MuTerry/microgrid-stm32/README.md

# STM32 微电网控制项目

基于 NUCLEO-F446RE，实现 CAN 功率指令接收、四路 PWM 控制、模拟量采样和电流 PI 控制，逐步接入真实传感器与 Buck 功率级。

**进度更新：2026-11-09**（归档 11 月 8 日第二轮测试；硬件测量已暂停）

**固件基线：`153e2b0`**（CAN、PWM、双 ADC 与电位器反馈 PI 台架测试）

**当前观察固件：`2cbbc6e`**（PA1 原始 ADC 观察模式；后续更新为测试记录与离线分析，未改固件）

当前阶段：**正、反向小电流基础响应与撤载回零均已观察到。新增零输入与 3V3 分压中点对照表现较好；恢复 ACS758 后，ADC 估算与万用表仍差约 9.67 mV。表笔接入与报告间交替波动有关联，原因未定位。测量已暂停，测点与地线压差检查待下次进行。正式标定、精度验证和真实功率 PI 收敛尚未完成。**

当前源码默认 `ADC_RAW_TEST_MODE=1`：只采 PA1、四路 PWM 保持为零、暂停 `0x200` 发送，串口每约 250 ms 输出原始 ADC 数据。下面列出的 CAN 测量反馈和电位器 PI 为既有基线验证结果，不代表观察模式正在执行这些功能。心跳接收与超时锁存仍运行。

## 已完成

### 固件与通信

- [x] 工程备份，固件基线已推送 GitHub。
- [x] CAN 通信测试，波特率 500 kbit/s。
- [x] 接收 `0x100` 功率指令、`0x102` 光伏/风电指令和 `0x101` 心跳，发送 `0x200` 状态反馈。
- [x] TIM3 四路 20 kHz PWM 输出测试：PA6 光伏、PA7 燃料电池、PB0 电池、PB1 风电。
- [x] ADC1 双路采样测试：PA0 模拟母线电压，PA1 模拟电流。
- [x] 光伏单路 PI 的电位器反馈方向与限幅测试；其余三路当前仍为开环控制。
- [x] 心跳超时保护：超过 1000 ms 未收到有效心跳，关闭全部 PWM、置故障码 5 并锁存，手动复位恢复。

**心跳超时关闭并锁存是当前明确保留的行为。总路线资料中的下垂控制不作为当前固件行为。**

### HW-525 / ACS758 硬件测试

- [x] 焊接 HW-525 四针排针和 IP+/IP− 功率引线。
- [x] 使用 20 Ω / 50 W 电阻搭建串联负载回路，断电实测回路约 19.74 Ω。
- [x] 模块独立供电检查，空载耗电约 22 mA。
- [x] 分离供电下完成零电流、正向电流、反向电流及撤载回零测试。
- [x] 在约 ±0.5 A 范围内，确认正向电流使输出升高、反向电流使输出降低，两路输出接近。

以下为人工台架测试记录，测试时 OUT1/OUT2 均未接入 STM32 ADC：

| 状态 | 被测电流 | 模块 VCC | OUT1 | OUT2 |
|---|---:|---:|---:|---:|
| 无电流 | 0 A | 4.957 V | 2.481 V | 2.482 V |
| 正向小电流 | +0.245 A | 4.956 V | 2.490 V | 2.492 V |
| 正向电流 | +0.491 A | 4.958 V | 2.500 V | 2.501 V |
| 撤载回零 | 0 A | 4.958 V | 2.481 V | 2.482 V |
| 反向电流 | −0.491 A | 4.957 V | 2.462 V | 2.462 V |

测试供电：电脑 USB 给 NUCLEO-F446RE 供电，开发板 5 V/GND 给传感器模块供电；台式电源单独给 IP+/IP− 与电阻组成的负载回路供电。

结合模块资料及断电电阻测量，**推断 OUT1 为直接/滤波输出，OUT2 为运放缓冲输出**。尚未完整追踪 PCB 原理图，CJMCU-758 资料与 HW-525 实物也存在版本差异，不能把输出编号对应关系视为完全确认。两路测试结果支持近似相同的直流增益。

本次测得的零点及粗估灵敏度仅用于基础功能判断，尚不是正式标定参数。早期模块与负载共用台式电源的测试数据不用于标定。上述模块独立测试阶段未修改、编译或烧录固件。

### 分压接入记录（2026-10-17）

- [x] 搭建 OUT2 → R1（10 kΩ）→ A；A 经 R2（10 kΩ）接信号地，经 R3（1 kΩ）接 B；B 经 100 nF 电容接信号地。
- [x] B 未接 PA1 时，最后一轮零电流测得模块 VCC=4.973 V、OUT2=2.495 V、B=1.2453 V，静态分压比约 0.49912。
- [x] B 已接 PA1，用户报告 PA1 对地电压为 1.2377 V。两次读数并非同步测量，不能据此直接判断接入造成的压降。

电阻最初在面包板电路中测得 8.884/8.884/1.0077（按 kΩ 理解）；取出后用户报告 10.0013 kΩ。该读数尚未逐一对应 R1/R2，正式标定前应分别记录两只分压电阻的独立测量值。当前不把在电路中的读数用于计算精确分压比。

早期测量曾记录 VCC 约 4.494 V，与最后一轮 4.973 V 不一致，原因未确认；不改写早期记录，也不混合各轮数据标定。静态分压验证不代表完整故障保护验证。

### 原始 ADC 观察验证（2026-10-17）

- [x] 加入并编译原始 ADC 观察固件，用户板端已提供串口截图。
- [x] 截图 28 组输出均为 `n=32 err=0`，合计报告 896 次有效采样。
- [x] `avg=1551～1553`，按暂定 3.300 V 参考电压估算 `mV=1250～1251`。
- [x] 故障状态 `safe=1 fault=5` 下，ADC 观察输出继续。

单次原始值跨组范围为 1544～1562，约对应 14.51 mV 的峰峰范围；组平均值变化仅 2 个码值。这里验证的是采样和输出的基础功能，尚未确认电压准确度、正式零点、完整量程或 ADC 电流跟踪。

详见 [测试分析与结论](docs/tests/2026-10-17-pa1-adc-raw.md)、[原始截图](docs/tests/assets/2026-10-17-pa1-adc-raw.png) 和 [逐行转录 CSV](docs/tests/data/2026-10-17-pa1-adc-raw.csv)。截图不含时间戳，CSV 是统计输出转录，不是逐点原始波形。

### 静态电压与电流响应复核（2026-10-20）

- [x] 一组同轮静态数据中，OUT2=2.380 V、PA1=1.1909 V，分压比约 0.50038；用开发板实测 3.291 V 近似参考电压，`avg=1480` 对应约 1.1894 V，相差约 1.5 mV。
- [x] 正向 +0.484 A 时，相对本轮前后零点平均值，PA1 上升 9.8 mV、ADC 增加 12 个计数；撤载后回到初始值附近。
- [x] 反向 −0.490 A 时，PA1 和 ADC 均下降，方向符合预期。
- 当日反向幅度未对齐：PA1 实测变化 −5.9 mV，ADC 变化 −12.5 个计数；若参考电压约 3.29 V，后者约对应 −10.0 mV。该历史轮次不作标定，后续进展见 11 月 8 日记录。

串口曾无法打开、随后恢复，具体恢复原因未确认。用户曾报告移动开发板会改变读数并伴随 STM32 明显发热；在铁质桌面上改为绝缘放置并固定接线后，报告未再明显发热。怀疑板底接触金属造成间歇短路，未直接测得故障点，不能写成已确诊或已完成损伤排除。后续保持绝缘支撑和固定接线。

不同轮次零点及模块供电发生变化，不混用零点，也不将单点灵敏度粗估写入固件。完整人工记录、计算和待复测步骤见 [10 月 20 日测试报告](docs/tests/2026-10-20-pa1-current-response.md)。

### 连接排查与反向响应复测（2026-10-22～11-08）

- [x] 打通 MobaXterm 串口文本与 UT61E+ 万用表 CSV 导出；当前没有持续自动采集，串口没有逐行时间戳。
- [x] 记录漏接地导致 `avg=4095`、补地后恢复的现象；`err=0` 不能证明接线或输入电压正常。
- [x] 11 月 8 日归档四对原始 CSV/TXT，保留异常片段及 SHA-256，并提供离线复算脚本。
- [x] `vcc-cycle` 中模块 VCC=4.957～4.961 V，ADC 平台均值约 1568.63 → 1557.41 → 1568.87，观察到反向下降和撤载回零。
- [x] 最后 `pa1-cycle` 在 −0.479 A 下，两种仪器均观察到下降和回零。按明确内部窗口复算，PA1 变化约 −9.06 mV、ADC 变化约 −11.82 个计数；以本轮普通 3V3=3.278 V 近似换算约 −9.46 mV，变化幅度相差约 0.40 mV。与侧对话原选窗约 −9.075/−9.492 mV 的结论一致。
- 当轮 ADC 绝对电压偏高约 16～17 mV，单条 `avg` 波动明显；后续零输入、中点与 ACS758 对照见下节，历史数据不改写。

首轮 `reverse` 存在明显基线变化，不用于标定。历史上轻碰电脑端开发板 USB 线会改变读数；具体故障点和本次改善原因未确认，不能宣布 USB 问题彻底解决，也不能把万用表 USB 插拔时的变化归因于其通信本身。

详见 [11 月 8 日测试分析与下一步测点](docs/tests/2026-11-08-pa1-reverse-response.md)、[原始数据](docs/tests/data/2026-11-08/)、[复算脚本](docs/tests/analyze_2026_11_08.py) 及 [10 月 22 日至 11 月 7 日交接补记](docs/tests/2026-10-22-to-11-07-connection-notes.md)。上述改善只支持小电流基础功能，不能写成正式灵敏度、精度或真实 PI 验证通过。

### 零输入、中点和表笔对照（2026-11-08 第二轮）

- [x] 用户报告初次 AVDD 与普通 3V3 均为 3.270 V；只说明该次未观察到差异，不证明其他测试时参考电压不变。
- [x] PA1 经独立 1 kΩ 接 GND：155 条报告，avg=1～2、均值 1.329，零输入接近零。
- [x] 将分压上端从 OUT2 改接 3V3：万用表均值 1.647290 V、ADC 均值 2046.0605；按本轮 3.299～3.300 V 估算，均值电压差约 +1.05～+1.55 mV。
- [x] 红表笔移开后，报告间交替减弱，接回后再次出现；组内原始采样峰峰值没有同步减小，不能把全部噪声归因于表笔。
- [x] 最终已恢复 OUT2 分压接 PA1，R1 上端与 3V3 断开。零电流下万用表均值 1.226085 V、ADC 均值 1540.4596；按记录前后 AVDD=3.285 V 估算，ADC 为 1.235753 V，差约 +9.668 mV。
- [ ] 偏差原因、测点与地线压差尚未确认；三个压差检查均未执行，不记为接线故障已发现。

本轮七份新增原始文件、完整统计与限制见 [第二轮测试报告](docs/tests/2026-11-08-pa1-input-probe-controls.md)。串口无逐行时间戳，以上均为记录段比较。当前用户已暂停测量；恢复后利用已有对照缩小排查范围，不默认重做零输入与中点测试。

### 当前观察固件

- USART2：115200、8N1；每组采 32 次，输出 `avg/min/max/mV/n/err/safe/fault`。
- `mV` 使用暂定参考电压 3300 mV，表示 PA1 电压，不是 OUT2 电压或真实电流。
- 观察模式在初始化后将 ADC1 改为单通道 PA1，避免轮询读取双通道扫描时的数据覆盖；CubeMX `.ioc` 保留原双通道基线配置。
- 没有 CAN 心跳时，约 1 s 后出现 `HEARTBEAT TIMEOUT`、`safe=1 fault=5`，原始值观察仍继续；心跳恢复不会清除锁存，需手动复位。
- 当前模式屏蔽 CAN 功率指令对 PWM 的写入，不运行 PI，不发送仍含电位器换算的 `0x200`。

`ADC_RAW_TEST_MODE=0` 仅恢复旧电位器台架逻辑，不能用来启用 ACS758 真实闭环。当前阶段尚未加入零点标定或真实电流换算。

## 正在做

**硬件测量暂停；整理已有对照，缩小 ACS758 接入时绝对电压偏差的排查范围。**

当前恢复为 ACS758 OUT2 分压滤波接 PA1，负载关闭、PWM 不接功率级。下次优先同轮核对模块地、滤波地相对开发板 GND，以及 PA1 与 B 点之间的压差，区分实际电位差与换算/采样波动；上述三项尚无结果。

不同轮次的 3V3/AVDD 分开使用，人工前后测量不代替全程同步参考电压。串口 `mV` 仍按名义 3300 mV 计算，尚未加入固定偏移、正式零点或电流标定系数。

## 未完成

### 当前优先事项

- [ ] 利用现有零输入/中点/ACS758 对照核查测点与参考地，解释绝对电压偏差；继续区分表笔相关的报告间交替与组内采样波动。现有记录段比较不代表逐点同步或完整精度验证。
- [ ] 完成正式零点标定及已知正反向电流的 ADC 增量、回零与换算精度验证。
- [ ] 统一修改 PI 反馈和 CAN 上报中两处电位器电流换算，纳入实际分压比例与标定参数。
- [ ] 明确单支路电流与总母线电流的测量及上报含义，避免把单支路读数直接当作四支路总电流。
- [ ] 验证真实母线电压采样及标定。
- [ ] 搭建单路 Buck，先验证驱动波形和开环带载运行，再验证真实电流 PI 收敛。

### 后续系统工作

- [ ] 根据实际功率级整定 PI，验证采样与控制周期；当前主循环调度并非严格的 1 kHz 控制环。
- [ ] 完成过压、欠压、过流、过温等保护及故障验证。
- [ ] 完善 CAN 帧校验、急停处理和状态反馈；当前 Pbatt 与 SOC 仍为占位值。
- [ ] 在单路验证通过后扩展四路功率级、支路电流采样和控制。
- [ ] 对接实时仿真机，完成多支路联调、故障注入和长时间运行测试。
- [ ] 按项目阶段加入 OLED、辅助测量和展示功能。

进入功率级阶段前，还需按实物核对 6N137 驱动链路、供电方案及 Buck 输入与母线之间的电压余量。总体路线资料中的器件和参数不直接视为已验证设计。

## 下一步顺序

**参考电压与测量偏差排查 → 稳定供电下重复验证 → 正式零点与已知电流标定 → 单路 Buck 开环 → 单路真实 PI 闭环 → 四路扩展与系统联调。**

主程序位于 [Core/Src/main.c](Core/Src/main.c)，引脚初始化位于 [Core/Src/stm32f4xx_hal_msp.c](Core/Src/stm32f4xx_hal_msp.c)。
