MuTerry/microgrid-stm32/docs/tests/data/2026-11-08/acs-zero-check.csv

No. | Date/Time | Function | Range | Value | Unit
1 | 2026-11-08 18:18:28 | DCV | 2 | 1.2261 | V
2 | 2026-11-08 18:18:29 | DCV | 2 | 1.2261 | V
3 | 2026-11-08 18:18:30 | DCV | 2 | 1.2261 | V
4 | 2026-11-08 18:18:31 | DCV | 2 | 1.2261 | V
5 | 2026-11-08 18:18:32 | DCV | 2 | 1.2261 | V
6 | 2026-11-08 18:18:33 | DCV | 2 | 1.2261 | V
7 | 2026-11-08 18:18:34 | DCV | 2 | 1.2261 | V
8 | 2026-11-08 18:18:35 | DCV | 2 | 1.2261 | V
9 | 2026-11-08 18:18:36 | DCV | 2 | 1.2262 | V
10 | 2026-11-08 18:18:37 | DCV | 2 | 1.2262 | V
11 | 2026-11-08 18:18:38 | DCV | 2 | 1.2262 | V
12 | 2026-11-08 18:18:39 | DCV | 2 | 1.2262 | V
13 | 2026-11-08 18:18:40 | DCV | 2 | 1.2262 | V
14 | 2026-11-08 18:18:41 | DCV | 2 | 1.2262 | V
15 | 2026-11-08 18:18:42 | DCV | 2 | 1.2262 | V
16 | 2026-11-08 18:18:43 | DCV | 2 | 1.2262 | V
17 | 2026-11-08 18:18:44 | DCV | 2 | 1.2262 | V
18 | 2026-11-08 18:18:45 | DCV | 2 | 1.2262 | V
19 | 2026-11-08 18:18:46 | DCV | 2 | 1.2262 | V
20 | 2026-11-08 18:18:47 | DCV | 2 | 1.2262 | V
21 | 2026-11-08 18:18:48 | DCV | 2 | 1.2262 | V
22 | 2026-11-08 18:18:49 | DCV | 2 | 1.2263 | V
23 | 2026-11-08 18:18:50 | DCV | 2 | 1.2263 | V
24 | 2026-11-08 18:18:51 | DCV | 2 | 1.2262 | V
25 | 2026-11-08 18:18:52 | DCV | 2 | 1.2261 | V
26 | 2026-11-08 18:18:53 | DCV | 2 | 1.2261 | V
27 | 2026-11-08 18:18:54 | DCV | 2 | 1.2261 | V
28 | 2026-11-08 18:18:55 | DCV | 2 | 1.2261 | V
29 | 2026-11-08 18:18:56 | DCV | 2 | 1.2261 | V
30 | 2026-11-08 18:18:57 | DCV | 2 | 1.2261 | V
31 | 2026-11-08 18:18:58 | DCV | 2 | 1.2261 | V
32 | 2026-11-08 18:18:59 | DCV | 2 | 1.2260 | V
33 | 2026-11-08 18:19:00 | DCV | 2 | 1.2260 | V
34 | 2026-11-08 18:19:01 | DCV | 2 | 1.2260 | V
35 | 2026-11-08 18:19:02 | DCV | 2 | 1.2260 | V
36 | 2026-11-08 18:19:03 | DCV | 2 | 1.2261 | V
37 | 2026-11-08 18:19:04 | DCV | 2 | 1.2261 | V
38 | 2026-11-08 18:19:05 | DCV | 2 | 1.2260 | V
39 | 2026-11-08 18:19:06 | DCV | 2 | 1.2260 | V
40 | 2026-11-08 18:19:07 | DCV | 2 | 1.2260 | V
41 | 2026-11-08 18:19:08 | DCV | 2 | 1.2260 | V
42 | 2026-11-08 18:19:09 | DCV | 2 | 1.2261 | V
43 | 2026-11-08 18:19:10 | DCV | 2 | 1.2260 | V
44 | 2026-11-08 18:19:11 | DCV | 2 | 1.2260 | V
45 | 2026-11-08 18:19:12 | DCV | 2 | 1.2260 | V
46 | 2026-11-08 18:19:13 | DCV | 2 | 1.2261 | V
47 | 2026-11-08 18:19:14 | DCV | 2 | 1.2260 | V
48 | 2026-11-08 18:19:15 | DCV | 2 | 1.2260 | V
49 | 2026-11-08 18:19:16 | DCV | 2 | 1.2261 | V
50 | 2026-11-08 18:19:17 | DCV | 2 | 1.2261 | V
51 | 2026-11-08 18:19:18 | DCV | 2 | 1.2261 | V
52 | 2026-11-08 18:19:19 | DCV | 2 | 1.2261 | V
53 | 2026-11-08 18:19:20 | DCV | 2 | 1.2261 | V
54 | 2026-11-08 18:19:21 | DCV | 2 | 1.2261 | V
55 | 2026-11-08 18:19:22 | DCV | 2 | 1.2261 | V
56 | 2026-11-08 18:19:23 | DCV | 2 | 1.2260 | V
57 | 2026-11-08 18:19:24 | DCV | 2 | 1.2259 | V
58 | 2026-11-08 18:19:25 | DCV | 2 | 1.2259 | V
59 | 2026-11-08 18:19:26 | DCV | 2 | 1.2259 | V
60 | 2026-11-08 18:19:27 | DCV | 2 | 1.2258 | V
61 | 2026-11-08 18:19:28 | DCV | 2 | 1.2259 | V
62 | 2026-11-08 18:19:29 | DCV | 2 | 1.2259 | V
