MuTerry/microgrid-stm32/docs/tests/2026-11-08-pa1-input-probe-controls.md

# PA1 零输入、中点和表笔接入对照

测试日期：2026-11-08；归档日期：2026-11-09。承接[当日反向响应测试](2026-11-08-pa1-reverse-response.md)。归档前本地与远程 master 均核验为 `82d9066`。

侧对话报告只读操作、未核验 HEAD；本次主对话读取七份新增文件、复算并更新归档，没有修改 STM32 固件、编译或烧录。当前仍为 `2cbbc6e` 的 PA1 观察固件，保留心跳超时关闭全部 PWM、锁存、手动复位恢复。

**用户已要求暂停测量。下面压差检查均未执行，不记录为已发现的接线问题。**

## 当前判断

- PA1 经独立 1 kΩ 接开发板 GND 时，读数接近零。
- 开发板 3V3 经原分压滤波网络输入 PA1 时，段均值对应较好，未复现此前 16～17 mV 偏差。
- 移开红表笔时，相邻报告高低交替减弱；接回后再次出现，支持关联，尚未定位原因。
- 恢复 5V 供电的 ACS758 输出链路后，绝对电压偏差再次出现，约 +9.668 mV。

上述是不同条件、不同时间段的对照，不能直接定位到传感器或 ADC。中点输入来自 3V3 分压，与 5V 供电的 ACS758 输入条件不同；若输入与 ADC 参考电压随同一电源一起变化，码值比例可能较稳定。因此中点表现较好不能排除其他工况中的参考电压或测量时序问题。未在固件中加入固定偏移或标定系数。

## 数据来源与复算口径

原始文件来自用户桌面 `data` 目录；本次逐字节复制七份新文件至[同日数据目录](data/2026-11-08/)，保留原始内容及换行。前八份原始文件不变。完整统计、SHA-256、残缺文本见 [analysis.json](data/2026-11-08/analysis.json)；[复算脚本](analyze_2026_11_08.py) 已扩展为读取这十五份文件。

本报告均值使用各文件全部完整报告，不裁选稳定平台。CSV 带时间，TXT 没有逐行时间戳，比较为记录段统计，并非严格逐点同步。`avg` 是固件每组 32 次采样平均后的整数报告，再对这些报告取均值；`min/max` 是组内原始采样极值，不是另存的逐点波形。

全部完整串口报告均为 `n=32 err=0 safe=1 fault=5`。`err=0` 只表示采样调用未报错。红表笔 off/on 文件的残缺前缀不纳入统计，其后完整报告保留；两份文件不属于前一份完整记录的累计前缀导出。

## 参考供电与零输入

用户最初报告 AVDD=3.270 V、普通 3V3=3.270 V。本次没有两个测点之间的可见差异，但不能推断所有测试期间参考电压始终不变。

随后断开传感器到 PA1 的信号线，PA1 经独立 1 kΩ 接开发板 GND：

| 文件 | 完整报告数 | avg 范围 | avg 均值 | 组内原始采样跨文件范围 |
|---|---:|---|---:|---|
| pa1-ground.txt | 155 | 1～2 | 1.329032 | 0～13 |

这支持零输入时 ADC 接近零，不是全量程准确性验证。

## 3V3 分压中点

R1 上端与 OUT2 断开，改接开发板 3V3；保留 10 kΩ/10 kΩ 分压、1 kΩ、100 nF，B 接 PA1。用户记录前后参考电压均报告为 3.299/3.300 V，本次按 3.299～3.300 V 区间估算，不将其当作全程同步参考电压曲线。

| 项目 | 复核结果 |
|---|---|
| pa1-mid.csv | 61 条，17:57:49～17:58:49；1.6472～1.6473 V，均值 1.647290164 V |
| pa1-mid.txt | 281 条；avg=2036～2055，均值 2046.060498 |
| 按参考区间估算 ADC 电压 | 1.648340313～1.648839962 V |
| ADC 估算减万用表均值 | +1.050150～+1.549798 mV |

本轮均值对应较好，单条 ADC 报告仍存在交替和短时波动。不能将单次约半量程的比较视为完整增益、线性或精度标定。

## 红表笔移开与接回

用户按要求保持 3V3 分压输入、黑表笔、开发板 USB 和其他接线不动，仅移开/接回红表笔。

| 状态 / TXT 文件 | 完整报告数 | avg 范围 | avg 均值 | 相邻 avg 差的绝对值均值 / 计数 | 组内 max−min 均值 / 计数 |
|---|---:|---|---:|---:|---:|
| 原先接表笔 / pa1-mid | 281 | 2036～2055 | 2046.060498 | 5.604 | 45.829 |
| 移开 / pa1-mid-probe-off | 212 | 2042～2054 | 2047.665094 | 2.668 | 50.858 |
| 接回 / pa1-mid-probe-on | 202 | 2039～2053 | 2045.975248 | 4.517 | 40.084 |

按完整报告的先后顺序计算，相邻 `avg` 的相关系数依次约 −0.698、−0.057、−0.660。它描述相邻报告高低交替的变化，不代表已测得噪声频率或干扰来源。串口无时间戳，残缺文本也可能对应缺失的报告。

报告间变化减弱时，组内原始采样峰峰值并未同步下降；所以不能把全部噪声归因于表笔。此处不把相关性写成电气加载、接地、USB 通信或某一种耦合机制已确诊。

## 恢复 ACS758 后的零电流

最终接线已由用户确认恢复：开发板 5V/GND 给 HW-525 供电；OUT2 经 10 kΩ/10 kΩ、1 kΩ、100 nF 接 PA1，分压滤波地与模块地接开发板 GND。**R1 上端已与 3V3 断开，OUT1 悬空，负载关闭，PWM 不接功率级。**

| 测量项 | 记录前 | 记录后 |
|---|---:|---:|
| AVDD | 3.285 V | 3.285 V |
| 模块 VCC | 4.953 V | 4.951 V |

| 项目 | 复核结果 |
|---|---|
| acs-zero-check.csv | 62 条，18:18:28～18:19:29；1.2258～1.2263 V，均值 1.226085484 V |
| acs-zero-check.txt | 285 条；avg=1532～1548，均值 1540.459649 |
| 以 3.285 V 估算 ADC 均值电压 | 1540.459649 × 3.285 / 4095 = 1.235753345 V |
| ADC 估算减万用表均值 | +9.667861 mV |

记录前后的 AVDD 相同不证明期间没有波动。绝对电压差再次出现，原因仍未确定；该差值也不能直接作为 ACS758 零点校正量。传感器零点、灵敏度和 ADC 电压对应关系需要分别验证。

## 暂停点与下次最小排查范围

现有零输入与中点对照已完成，不默认重做。三项待查是：**模块 GND 对开发板 GND、滤波电路 GND 对开发板 GND、PA1 对 B 点的压差**；尚无测量结果。

下次继续时，优先在保留当前 ACS758 零电流接线的同一轮中核对测点和参考地，使用上述压差区分“两个仪器实际看到不同电位”与“电压换算、时间平均或采样波动”。只排查能解释现有约 9.7 mV 差值的路径，不先做新的电流加载或重复全部静态测试。

若某一压差明显且方向、量级与偏差相符，再沿该段定位；若都接近零，应转向同阶段参考电压和采样/测量波动的比较，仍不能仅凭一次结果排除间歇接触。具体测量安排留到用户恢复测试时确定。

正式零点与灵敏度标定、绝对电压偏差解释、精度验证、USB 连接问题的根因与真实功率 PI 收敛均未完成。当前不改变心跳超时锁存行为。
