MuTerry/microgrid-stm32/docs/tests/2026-11-08-pa1-reverse-response.md

# PA1 反向小电流响应与参考电压待核对项

后续已收到参考供电、零输入、中点与表笔对照，见 [11 月 8 日第二轮记录](2026-11-08-pa1-input-probe-controls.md)。本文保留前一轮的数值和当时暂停点；同日数据目录与复算结果已追加后续七份记录。

测试日期：2026-11-08。归档前本地及远程 master 均核验为 `956c2c3`；固件仍为 `2cbbc6e` 中的 PA1 观察模式。本次仅归档数据、复算和更新文档，没有修改 STM32 固件、编译或烧录。心跳超时关闭全部 PWM、锁存、手动复位恢复的行为保持不变。

## 结论

反向约 −0.48 A 时，已获得万用表和 ADC 两方面的下降与撤载回零证据。最后一轮的平台均值比较中，电压变化幅度接近，差约 0.4 mV；这支持反向小电流基础功能，不等于完成灵敏度或精度标定。

按用户本轮测得的普通 3V3=3.278 V 近似参考电压，ADC 绝对电压仍比万用表高约 16～17 mV。单条 `avg` 仍明显波动，串口缺少逐行时间戳，USB 连接改善的具体原因尚未确认。下一步核对 AVDD 与普通 3V3，暂不调整换算系数或启用真实功率 PI。

## 接线与证据来源

```text
电脑 USB -> NUCLEO-F446RE -> 5V/GND -> HW-525 VCC/GND

OUT2 -- 10 kΩ -- A -- 1 kΩ -- B -> PA1
                 |            |
                10 kΩ        100 nF
                 |            |
信号 GND --------+------------+ -> 开发板 GND

反向回路：台式电源正极 -> IP− -> IP+ -> 20 Ω / 50 W -> 电源负极
```

OUT1 悬空，原电位器滑动端已移除。模块供电极性不随电流方向反转。负载回路使用独立台式电源，PWM 不接功率级。

硬件操作、电流大小及普通 3V3 读数来自用户交接；文件统计由本次直接读取原始记录复核。八个导出文件从用户桌面 `data` 目录逐字节复制至 [原始数据目录](data/2026-11-08/)，未清洗覆盖。文件校验值、完整报告数量、残缺文本与明确选窗边界保存在 [analysis.json](data/2026-11-08/analysis.json)。

| 文件 | CSV 条数 | TXT 完整报告数 | 用途 |
|---|---:|---:|---|
| pa1-dmm-2026-11-08.csv / pa1-adc-2026-11-08.txt | 398 | 1593 | 初始无电流观察 |
| reverse.csv / reverse.txt | 228 | 1073 | 首轮反向，明显基线变化 |
| vcc-cycle.csv / vcc-cycle.txt | 196 | 794 | 万用表测 VCC，ADC 测 PA1 |
| pa1-cycle.csv / pa1-cycle.txt | 192 | 789 | 万用表与 ADC 均观察 PA1 |

所有 CSV 均为 DCV、单位 V。所有解析出的完整串口报告均为 `n=32 err=0 safe=1 fault=5`。`err=0` 只说明采样调用未报错，不能证明输入电压或接线正常；每条报告含 32 次采样的统计量，并非 32 个逐点原始值。

解析器保留损坏前缀之后的完整报告；残缺部分另列，不拼补数据。`reverse.txt` 开头残留 `PA1 avg=1565`，`pa1-cycle.txt` 开头残留 `PA1 avg=156x`。`vcc-cycle.txt` 前三条完整报告的 `avg` 为 3、4、4，随后还有残缺的 `avg=5` 文本，来源未确认。这些仍保存在原始文件中，但不进入所选稳定片段。

## 初始无电流与首轮 reverse

初始万用表记录覆盖 16:12:55～16:19:32，范围 1.2429～1.2437 V，均值 1.243180 V。串口全文件 `avg` 范围 1551～1566，均值 1558.8506。两份记录没有可核实的逐点时间对应关系，不据此直接计算静态误差或正式零点。

首轮 `reverse` 用户报告电流大小 0.480 A、表笔未移动。按“关闭→反向加载→关闭”的计划和数据跳变，主要切换位置推测约为 16:35:37、16:37:01，未有独立操作时间标记确认。

交接记录报告首尾稳定片段相差约 +17.77 mV。归档另选三个内部片段复算，均值为 1.171397 → 1.179327 → 1.188937 V，首尾相差 +17.54 mV。选窗差异不改变“基线连续上升、首次切换附近明显跳动”的判断。原因未定位，该轮不用于标定，也不作为反向测试通过的证据。

## vcc-cycle：供电较稳的一轮

模块 VCC 共 196 条，范围 4.957～4.961 V，均值 4.958827 V；该记录覆盖 16:48:27～16:51:42。它与后面的 `pa1-cycle` 属于不同记录轮次，不当作后者的同步 VCC。

ADC 三个所选片段均值为 **1568.6333 → 1557.4083 → 1568.8667**，支持反向加载下降、撤载回零。本轮供电较稳不解释上一轮的异常，也不证明 USB 接触问题已彻底解决。

## pa1-cycle：反向变化与回零

用户报告本轮普通 3V3=3.278 V，反向电流为 −0.479 A。3V3 是人工测量值，没有全程同步参考电压记录，尚未确认与芯片模拟参考电源完全一致。

下面保留用户交接的片段均值；原交接未列选窗边界，不将这些均值描述为脚本逐点同步结果：

| 状态 | PA1 万用表均值 / V | ADC avg 均值 |
|---|---:|---:|
| 加载前 | 1.238247 | 1567.71 |
| 反向加载 | 1.229223 | 1555.79 |
| 撤载后 | 1.238350 | 1567.59 |

交接使用未四舍五入的统计结果报告：相对前后零点均值，万用表变化 −9.075 mV，ADC 变化 −11.858 个计数，按 3.278 V 近似换算为 −9.492 mV；差约 0.42 mV。前后零点变化约 +0.103 mV、−0.117 个计数。粗估 PA1 灵敏度分别为 18.95、19.82 mV/A，均不能作为固定标定系数。

为让归档可复算，本次按平台内部明确另选窗口，每个 DMM 窗口 30 条、每个 ADC 窗口 120 条，排除明显切换部分；不通过移动窗口使两种仪器读数相等：

| 状态 | CSV 数据行及时间 | TXT 完整报告序号 | DMM 均值 / V | ADC 均值 | ADC avg 范围 |
|---|---|---|---:|---:|---|
| 加载前 | 31～60，16:57:07～16:57:36 | 121～240 | 1.238260 | 1567.708333 | 1559～1577 |
| 反向加载 | 91～120，16:58:07～16:58:36 | 341～460 | 1.229247 | 1555.833333 | 1546～1564 |
| 撤载后 | 141～170，16:58:57～16:59:26 | 601～720 | 1.238350 | 1567.591667 | 1556～1575 |

CSV 行号不含表头；TXT 序号按解析出的完整报告计数。串口序号不等同于时间戳，两个窗口只能按同一平台阶段比较，不能宣称同步。

本次复算：

```text
零点参考 = (加载前均值 + 撤载后均值) / 2
万用表变化 = −9.058333 mV
ADC 变化 = −11.816667 个计数
ADC 估算变化 = −11.816667 × 3.278 / 4095 × 1000 = −9.459105 mV
两种变化相差 = 0.400771 mV
撤载后减加载前：万用表 +0.090 mV；ADC −0.116667 个计数
```

两组选窗结果接近，支持交接的基础功能结论。单条 `avg` 跨度仍可达 18～19 个计数，不能将平台均值的一致性解释成单条报告已达到相同精度。前后零点均值只作本轮比较，不证明漂移线性，不能混入其他上电轮次或永久写死。

用本次片段均值和 3.278 V 换算，ADC 减万用表的绝对电压差依次为 **+16.67、+16.18、+16.49 mV**。由增量较接近无法消除这项偏差，也尚不能据此确认 ADC、传感器或 USB 的故障原因。

## 复算方法

从仓库根目录运行：

```powershell
python docs/tests/analyze_2026_11_08.py
```

只读取归档文件，将 JSON 输出到终端，不连接硬件或改写原始数据。`analysis.json` 为同一函数的保存结果。

其他平台窗口同样使用一基闭区间：`reverse.csv` 为 41～70 / 111～140 / 181～210，`reverse.txt` 为 121～240 / 521～640 / 881～1000；`vcc-cycle.txt` 为 121～240 / 361～480 / 641～760。所有原始数据保留，未把其他区间删除。全文件均值仅用于清点记录，不能视为单一稳定工况的均值。

## 下一步：测参考电压，暂不改固件

本地代码核对：`ADC_RAW_TEST_MODE=1`，ADC 为 12 位右对齐，观察模式只采 PA1；`mV` 仍按名义 3300 mV 计算。`avg` 与 `mV` 分别四舍五入，后者来自采样总和，不能总由显示的整数 `avg` 精确反算。未发现本轮新增的换算代码修改。

NUCLEO-F446RE 上可用的排针测点：普通 **3V3 为 CN6-4**；**AVDD/AREF 为 CN5-8**，也引出到 **CN10-7**；GND 可用 CN6-6/7 或 CN5-7；AGND 为 CN10-32。先按板上丝印与引脚编号确认，避免误认相邻 5 V 引脚。来源：[ST UM1724，表 19、29](https://www.st.com/resource/en/user_manual/um1724-stm32-nucleo64-boards-mb1136-stmicroelectronics.pdf)。

STM32F446RE 的 LQFP64 封装没有独立引出的 VREF+，内部连接到 VDDA；所以普通 3V3 读数不能代替对模拟电源的实测。[STM32F446 数据手册，电源与参考去耦说明](https://www.st.com/resource/en/datasheet/stm32f446re.pdf)

操作只做电压测量：

1. 台式负载输出关闭，板子绝缘固定，PWM 保持不接功率级。需要布置测量引线时先断 USB；固定好共地和引线再上电，测量期间不插拔 USB。
2. 万用表置直流电压挡，黑表笔固定在同一开发板 GND，依次记录 **3V3 → AVDD → 3V3**，各观察约 30 s 的范围。使用排针测点，不用表笔碰 MCU 细脚，不给 AVDD 外加电源或改焊桥。
3. 黑表笔位置保持不变，再测 PA1，同时保留这一段串口日志。记录测量开始、结束和移动表笔的时间；若仍无串口时间戳，只做阶段均值比较。
4. 将本轮 AVDD/3V3/PA1 记录一起分析，再决定是否需要进一步检查模拟地、连接或采样噪声。不能先把某个电压或偏移写进固件来消除差异。

本轮尚未提供这些 AVDD 数据。正式零点、灵敏度、精度与重复性验证、真实功率 PI 收敛均未完成。停止测试时先关闭台式电源输出，再拔开发板 USB。
