MuTerry/microgrid-stm32/docs/tests/2026-10-20-pa1-current-response.md

# PA1 电压核对与正反向小电流响应记录

日期：2026-10-20。当前固件提交：`2cbbc6e`，`ADC_RAW_TEST_MODE=1`、`ADC_TEST_VREF_MV=3300`。

后续进展见 [2026-11-08 反向响应记录](2026-11-08-pa1-reverse-response.md)。本文保留 10 月 20 日当时的测量和待验证状态，不将后续结果回填为当日已完成。

证据来源：用户转交的侧对话文字记录，本轮未新增原始截图或串口日志文件。归档时复核了数值计算，没有替代用户进行硬件测量。侧对话未修改文件、编译、烧录或操作 Git；主对话本次只更新测试文档及 README，不修改固件、不编译或烧录。

## 当前结论

- 一组同轮测量中，分压比例约 0.50038；以开发板实测 3.291 V 近似 ADC 参考电压，ADC 估算与 PA1 万用表读数相差约 1.5 mV，静态对应关系良好。
- 正向 +0.484 A 时，PA1 相对本轮前后零点平均值上升 9.8 mV，ADC 增加 12 个计数；撤载后回到初始值附近，基础响应符合预期。
- 反向 −0.490 A 时，两种读数均下降，但万用表变化 −5.9 mV 与 ADC 变化 −12.5 个计数尚未对齐，反向幅度一致性仍待复测。
- 不同轮次的供电和零点存在变化，不能混用数据或写死零点。正式零点、灵敏度标定、精度和真实功率 PI 收敛均未完成。
- 心跳超时关闭全部 PWM、锁存、手动复位恢复的固件行为继续保留。

## 串口与异常发热排查

1. 曾出现 COM9 无法打开但 USB 仍供电。侧对话当时的只读检查未找到 COM9 或 ST-LINK USB 枚举，仅有 COM3/4/5/6 四个蓝牙串口。
2. 用户随后报告串口恢复，但未确认具体哪一步使其恢复，不能确定唯一原因。
3. 用户曾观察到移动开发板会改变 PA1 电压及 ADC 读数，中央 STM32 芯片明显发热。
4. 隔离检查时，开发板仅接 USB 不发烫；仅恢复模块 5 V/GND 也不发烫。
5. 用户发现桌面为铁质；绝缘放置并固定接线后，报告未再明显发热。

**怀疑板底裸露引脚或焊点接触金属桌面造成间歇短路，但未直接测得短路点，不能记为已确诊或已完成损伤排除。** 未提供温度测量，记录仅为用户对发热现象的观察；`avg=1300/1400` 等 ADC 值不代表温度或安全阈值。

## 测试接线与条件

```text
电脑 USB -> NUCLEO-F446RE
开发板 5 V / GND -> HW-525 VCC / GND

OUT2 -- 10 kΩ -- A -- 1 kΩ -- B -- PA1
                 |            |
                10 kΩ        100 nF
                 |            |
信号 GND --------+------------+
```

OUT1 悬空，原 PA1 电位器滑动端已移除，PWM 不接功率级。台式电源独立给 IP+/IP− 与 20 Ω / 50 W 电阻的串联回路供电。测试时使用绝缘支撑并固定接线。

下表数据按记录的先后轮次分别保留，不作为同一稳定供电下的连续标定数据。`avg` 为每组采样平均值的整数显示，串口 `mV` 是以名义 3300 mV 计算的结果，不是第二个独立电压测量。

## 绝缘放置后的无电流观察

| 组别 | PA1 万用表实测 / V | ADC avg | 串口 mV |
|---|---:|---:|---:|
| 1 | 1.1987 | 1496 | 1205 |
| 2 | 1.2010 | 1500 | 1209 |
| 3 | 1.2021 | 1503 | 1211 |

PA1 实测跨度 3.4 mV，ADC 跨度 7 个计数。该片段变化较小但仍在上升，不能当作已稳定的正式零点。

## 同轮供电与静态电压核对

| 测量项 | 实测 |
|---|---:|
| 开发板 3V3 | 3.291 V |
| 模块 VCC | 4.737 V |
| OUT2 | 2.380 V |
| PA1 | 1.1909 V |
| ADC avg | 1480 |

计算：

```text
分压比 = 1.1909 / 2.380 = 0.50038
ADC 估算电压 = 1480 × 3.291 / 4095 = 1.18942 V
PA1 实测与估算之差 = 1.1909 − 1.18942 ≈ 1.48 mV
```

这一组静态分压与 ADC 对应关系良好，但开发板 3V3 测量仅作参考轨近似，不能视为已精确测到芯片内部 VREF+，也不能将 1.48 mV 当作全量程精度指标。PA1 相比上一段末值下降 11.2 mV，不同轮次零点不可混用；后续测试也不能直接沿用 3.291 V 作为实际参考电压。

## 正向小电流响应

接线：台式电源正极 → IP+ → IP− → 20 Ω 电阻 → 台式电源负极。电源约 10 V，限流 0.6 A；用户报告加载电流 +0.484 A。

| 状态 | 模块 VCC / V | PA1 / V | ADC avg |
|---|---:|---:|---:|
| 加载前，0 A | 4.940 | 1.2398 | 1551 |
| 正向 +0.484 A | 4.940 | 1.2488 | 1562 |
| 撤载后，0 A | 4.939 | 1.2382 | 1549 |

以本轮前后零点平均值作临时比较参考：

- PA1 零点参考为 1.2390 V，ADC 零点参考为 1550。
- 加载变化为 +9.8 mV、+12 个计数。
- 撤载后相对初始变化为 −1.6 mV、−2 个计数。
- PA1 端单点粗估灵敏度约 20.25 mV/A；按标称 1/2 分压折算，分压前约 40.5 mV/A。

ACS758-050B 在 5 V 下典型灵敏度为 40 mV/A；按供电比例对 4.940 V 作近似估算约为 39.5 mV/A，对本轮电流和标称分压比预期约 +9.56 mV，接近观察结果。该估算依据芯片比例输出特性，模块级传递关系仍需实测标定。[Allegro 数据手册](https://www.allegromicro.com/-/media/files/datasheets/acs758-datasheet.pdf)

**正向小电流响应及撤载回零的基础表现符合预期。** 前后零点平均值只用于本轮趋势比较，没有时间戳来证明漂移线性，不能替代正式零点；单个电流点也不能建立精度指标或固定增益系数。

## 反向小电流响应与未解决差异

仅反转负载回路，模块 VCC/GND 极性不变：台式电源正极 → IP− → IP+ → 20 Ω 电阻 → 台式电源负极。用户报告电流大小 0.490 A，按接线记为 −0.490 A。

| 状态 | 模块 VCC / V | PA1 / V | ADC avg |
|---|---:|---:|---:|
| 加载前，0 A | 4.897 | 1.2312 | 1539 |
| 反向 −0.490 A | 4.898 | 1.2265 | 1529 |
| 撤载后，0 A | 4.899 | 1.2336 | 1544 |

- 本轮前后零点平均值为 PA1=1.2324 V、ADC=1541.5。
- PA1 实测加载变化为 −5.9 mV；ADC 变化为 −12.5 个计数。
- **仅在参考电压仍约 3.29 V 的假设下**，−12.5 个计数对应约 −10.04 mV；本轮加载时参考电压尚待实测。
- 按本轮 VCC=4.898 V、标称 40 mV/A（5 V 下）、约 1/2 分压和 −0.490 A 近似估算，PA1 预期变化约 −9.60 mV。
- 撤载后相对初始变化为 +2.4 mV、+5 个计数。

**方向正确，但万用表与 ADC 的变化幅度尚未对齐。** 可能涉及读数不同步、信号波动或参考电压变化，未确定原因。不能宣告反向灵敏度验证通过，也不能据此认定传感器异常；不使用这组差异计算正式增益修正。

## 待执行的复测

截至本记录，下面的复测尚未收到数据：

1. 保持绝缘、固定接线和反向负载回路，开启约 10 V、限流 0.6 A 的负载。
2. 记录本轮加载时的开发板 3V3 电压。
3. 将万用表表笔固定在 PA1 与信号 GND，每隔约 5 s 同步记录 PA1 电压和当时 ADC `avg`，共三组。
4. 测完关闭负载输出。

```text
本轮加载时 3V3：___ V
第 1 组：PA1 ___ V，avg ___
第 2 组：PA1 ___ V，avg ___
第 3 组：PA1 ___ V，avg ___
```

完成反向一致性复核后，仍需供电稳定条件下的正式零点、多点灵敏度与重复性验证，才能进入真实电流换算。当前模式继续保持 PWM 零占空比、暂停 PI 与 0x200 测量反馈，心跳超时锁存逻辑不变。
