MuTerry/microgrid-stm32/docs/tests/2026-10-22-to-11-07-connection-notes.md

# PA1 漂移与连接排查交接补记

归档日期：2026-11-08。以下来自用户提供的 2026-10-22 与 2026-11-07 侧对话交接，未重新读取这两日原始文件或重做硬件测试；数字作为交接记录保留，不标为本次独立复算结果。两轮侧对话均报告未修改工程、编译、烧录、提交或推送，也未核验 HEAD。

## 2026-10-22

- 曾记录模块 VCC=4.540～4.560 V、开发板 5V=4.520～4.524 V，非同时测量，不能相减为线路压降。
- 逐步恢复接线：USB 单独供电时 5V=4.922 V、3V3=3.300 V；仅模块 VCC/GND 接入时板端 5V=4.959 V、模块 VCC=4.950 V；接分压但未接 PA1 时 5V=4.925 V、OUT2=2.445 V、B=1.2213 V；B 接 PA1 后 5V=4.933 V、3V3=3.293 V、PA1=1.2332 V、avg=1537～1540。四阶段均报告没有异常发热。
- 原有低电压未在上述步骤中复现，但原因未定，间歇接触问题未排除。随后 PA1 上升到 1.2424 V、avg=1550；不同测量阶段仍有漂移。
- 后续 VCC=4.923～4.925 V 时 avg=1542～1547，VCC=4.910 V 时 avg≈1540；4.910 V 明确测的是 VCC，不能改写为 OUT2。供电与 ADC 同向变化不能证明唯一因果关系。
- 保留配对为 1.2449 V/1552、1.2450 V/1552、1.2458 V/1557；用户指出原 1.2425 V/1553 有问题，排除该对。保留值的万用表跨度 0.9 mV，ADC 跨度 5 个计数，尚未完全对应。
- 用户每次重新接触测点；“固定表笔”实际为手按住，不是夹住后松手。测量动作、接触或干扰未排除。安排无表笔、无触碰观察，当天未收到结果。

## 2026-11-07

- avg=4095、err=0 后发现漏接地；补接恢复 1539～1542，随后在无人触碰时下降到 1530～1532、1529～1531。后期数分钟变化较小，不等于正式零点。采样调用无报错不代表接线正确。
- 万用表确认为 UNI-T UT61E+，电脑程序为 UT61E+ v2.02。STM32 使用 MobaXterm 保存串口文本，万用表在 Record 区域导出 CSV；未建立持续自动采集或后台监控。串口无逐行时间戳。
- 桌面 `UT61E-2026-11-07.csv`：交接报告 17:35:02～17:42:45 共 464 条，范围 1.2161～1.2176 V，均值 1.216875 V。
- `pa1-2026-11-07.txt`：交接报告 6440 条；最后 600 条 avg=1507～1528，均值 1519.4467，有明显高低交替。全日志包含更早的大变化，不作为单一稳定工况。
- `pa1-dmm-usb-on.txt` 共 7954 条；`pa1-dmm-usb-off.txt` 共 8458 条，其前 7954 条与 on 相同，仅新增 504 条。不能把两份累计导出当作独立记录相加。

| 末尾各 240 条 | avg 范围 | 均值 |
|---|---|---:|
| 万用表 USB 接入 | 1508～1529 | 1520.0542 |
| 万用表 USB 拔掉 | 1545～1565 | 1554.8583 |

两段均为 `n=32 err=0 safe=1 fault=5`，高低交替未消失。平均上移约 34.8 个计数，以名义 3.3 V 估算约 28 mV。随后万用表直接读数 1.2444 V，与先前均值相比增加约 27.5 mV；不属于严格同步标定数据。

用户随后报告轻碰开发板 USB 线的电脑端会引起明显电压变化，认为接口较松。尚未通过可靠线缆、端口或另一台电脑定位故障点。插拔万用表 USB 可能牵动其他连接，**不能把变化归因于万用表 USB 通信本身**，也不能判断所有电脑接口、ADC 或传感器损坏。

曾讨论带独立电源的数据集线器，但无已购买或新方案完成接线的报告；稳压器不能解决机械接触不良。

## 后续状态

[11 月 8 日原始记录与分析](2026-11-08-pa1-reverse-response.md) 已补充反向小电流响应与回零证据；具体连接改善原因仍未知。不要把较好的一轮数据写成 USB 故障已彻底解决。下一步核对 AVDD 与普通 3V3，继续排查绝对电压偏差。
