MuTerry/microgrid-stm32/docs/tests/data/2026-10-17-pa1-adc-raw.csv

row | avg | min | max | mV | n | err | safe | fault
1 | 1553 | 1548 | 1558 | 1251 | 32 | 0 | 1 | 5
2 | 1553 | 1545 | 1557 | 1251 | 32 | 0 | 1 | 5
3 | 1552 | 1548 | 1558 | 1250 | 32 | 0 | 1 | 5
4 | 1552 | 1546 | 1558 | 1251 | 32 | 0 | 1 | 5
5 | 1552 | 1546 | 1557 | 1250 | 32 | 0 | 1 | 5
6 | 1552 | 1548 | 1557 | 1251 | 32 | 0 | 1 | 5
7 | 1551 | 1545 | 1558 | 1250 | 32 | 0 | 1 | 5
8 | 1551 | 1546 | 1556 | 1250 | 32 | 0 | 1 | 5
9 | 1551 | 1544 | 1556 | 1250 | 32 | 0 | 1 | 5
10 | 1552 | 1546 | 1560 | 1250 | 32 | 0 | 1 | 5
11 | 1551 | 1544 | 1558 | 1250 | 32 | 0 | 1 | 5
12 | 1551 | 1547 | 1556 | 1250 | 32 | 0 | 1 | 5
13 | 1552 | 1545 | 1558 | 1251 | 32 | 0 | 1 | 5
14 | 1552 | 1545 | 1561 | 1250 | 32 | 0 | 1 | 5
15 | 1552 | 1545 | 1560 | 1250 | 32 | 0 | 1 | 5
16 | 1551 | 1545 | 1556 | 1250 | 32 | 0 | 1 | 5
17 | 1552 | 1548 | 1558 | 1251 | 32 | 0 | 1 | 5
18 | 1552 | 1546 | 1557 | 1250 | 32 | 0 | 1 | 5
19 | 1551 | 1545 | 1557 | 1250 | 32 | 0 | 1 | 5
20 | 1551 | 1546 | 1560 | 1250 | 32 | 0 | 1 | 5
21 | 1552 | 1545 | 1560 | 1251 | 32 | 0 | 1 | 5
22 | 1552 | 1545 | 1558 | 1251 | 32 | 0 | 1 | 5
23 | 1552 | 1548 | 1560 | 1251 | 32 | 0 | 1 | 5
24 | 1551 | 1545 | 1556 | 1250 | 32 | 0 | 1 | 5
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
