MuTerry/microgrid-stm32/(commit log)

2026-10-12 Baseline: CAN PWM ADC potentiometer PI bench test
2026-10-17 feat: add PA1 ADC observation mode and bench test evidence
    [2026-10-17-pa1-adc-raw.csv]
2026-10-20 docs: record PA1 current response tests and pending reverse check
2026-11-08 docs: archive PA1 reverse response tests and reference voltage follow-up
    [pa1-cycle.csv, pa1-dmm-2026-11-08.csv, reverse.csv, vcc-cycle.csv]
2026-11-09 docs: archive PA1 input and probe controls with unresolved ACS voltage offset
    [acs-zero-check.csv, pa1-mid.csv]
